api-bar/chem-constructor/README.md

# Химический конструктор «атомы + связи» — v2.0-beta5

> **EN:** Printable molecular model kit "atoms + bonds", version 2 (beta). New bayonet / lens / Reuleaux keys: single bonds rotate freely, rings close (cyclohexane), flexible single bonds, bond lengths engraved in Å, new elements (F, Cl, Na, K, Mg, Ca, S, P). Scale 90 mm/Å, real bond lengths and angles. **Not compatible with v1.0.** Print `04_tester/00_v2_prism_keys.3mf` first. License: [CC BY-NC-ND 4.0](LICENSE).

Детский/учебный конструктор молекул для 3D-печати (Bambu Lab A1). Масштаб 90 мм/Å, реальные валентные углы и длины связей, цвета CPK.
Вторая версия: новое крепление связь↔атом (одинарные связи **вращаются**, кольца замыкаются), гибкие связи, маркировка длин, новые элементы.
**Детали v2 несовместимы с v1.0.** Отличия — `docs/CHANGES_v1_to_v2.md`.

> **Статус: beta.** Релиз v2.0 — после выбора гибкой связи (spring или slots) по результатам печати и проверки защёлок в пластике. См. `STATUS.md`.

> **Что в репозитории.** Параметрический исходник OpenSCAD и скрипты сборки и проверки (`00_source/`), документация (`docs/`) и PNG-превью. STL, 3MF, GLB и USDZ
> на GitHub не публикуются: они входят в комплект v2, который распространяется отдельно — см. [docs/RELEASE.md](docs/RELEASE.md) и раздел «Лицензия».
> Набор v1.0 заморожен на теге `v1.0` и больше не развивается. По готовности v2 вливается в `main`.

## Структура

Структура полной папки набора; в git из неё только текст и PNG (`.gitignore` работает как белый список).

| Папка | Что внутри |
|---|---|
| `00_source/` | `chem_constructor.scad` (параметрический исходник v2, OpenSCAD), `chemlib.py`, `molecules.py`, `assemble3.py`, кэш посадок `seat_cache_v2.json`; `pipeline/` — скрипты проверки, пластин, превью, USDZ. Исходник v1.0 — на теге `v1.0` |
| `01_components/atoms/` | C Ø56, O Ø52, **N Ø52 с двойным пазом**, H Ø44, заглушка неподелённой пары |
| `01_components/bonds_rigid_labelled/` | жёсткие связи с гравировкой длины в Å: C–C, C–H, C–O, C–N, N–H, O–H, H–H; C=C, C=O, O=O, **N=O, C=N, N=N**; C≡C, C≡N, N≡N; универсальные без надписи: **U1** (C–C/C–O), **U2** (C–H/N–H/O–H), **UD1** (C=C/C=N), **UD2** (C=O/O=O/N=O/N=N), **UT** (C≡C/C≡N/N≡N) |
| `01_components/bonds_flex_spring/`, `bonds_flex_slots/` | 7 одинарных связей в двух гибких вариантах (решётка-стент / трубка с прорезями и внутренней спиралью) |
| `02_molecules/` | сборки `.glb` / `.usdz` / `.png`: вода, метан, этилен, CO₂, ацетилен, аммиак, этанол, L-аланин, циклогексан, **NO** |
| `03_plates/` | пластины: `01_v2_atoms…` (минимальный набор атомов), `02_v2_bonds_rigid_22…` (связи с маркировкой + универсальные), `05–07` гибкие связи (тест стоя/лёжа, все одинарные по вариантам; устаревшая пластина 08 с гибридным NO удалена — NO собирается связью N=O), циклогексан и вода по цветам |
| `04_tester/` | призма + ключи v2, по одному атому и связи каждого типа, тест гибкости (шейка) |
| `05_flex_bonds/` | разрезы и USDZ spring/slots, старые тестовые пластины 03/04 четырёх кандидатов, `old_candidates_neck_bellows/` |
| `06_v2_test_plates/` | атомы C, O, H и связи к ним на отдельных пластинах |
| `07_v2_new_elements/` | F, Cl, Na, K, Mg, Ca, S, P, N: STL, пластины, README со списком недостающих связей |
| `docs/` | **`KIT_v2_CATALOG.md`** (подробное описание набора, все компоненты, каталог молекул), `CHANGES_v1_to_v2.md`, `FLEX_BONDS.md` (устройство spring/slots), `MIN_SET_8_MOLECULES.md` (минимальный набор для C₂H₂, C₂H₄, C₂H₅OH, CH₄, CO₂, HCN, NO, NH₃), `README_beta4.md` (описание крепления и булевых проверок), `GIT_WORKFLOW.md` |

## Крепление (кратко)
- **Одинарная:** цилиндр Ø15 с 3 бугорками → круглый паз с входными бороздками, губой (натяг 0,3 мм) и кольцевой канавкой на глубине 4,5 мм. Вставить, совместив бугорки с бороздками, нажать до щелчка; дальше связь вращается свободно.
- **Двойная:** винтовой ключ-линза 28×7, правый винт, 2 положения. **Тройная:** винтовой ключ-треугольник Рёло 15, 3 положения. Клин у кончика, защёлка на сжатии пластика.
- Чужой ключ в паз не входит. Пазы углерода (8 шт.) и гибридизации — как в v1 (см. `docs/README_beta4.md`).
- **Азот:** 3 одинарных (пирамида), паз заглушки, тройной напротив заглушки, **двойной** (sp²: 120° к T0; HO–N=O собирается плоским).

## Печать
- **Атомы** — PLA, плоскостью с гравировкой вниз, слой 0,2, 3 стенки, 15 %. Поддержки: Enable support + tree(auto) + **Support critical regions only** (островок ≤11 мм² в устье нижнего паза у углерода и азота).
- **Связи** — PETG (гибкие — обязательно PETG), **стоя**, без поддержек, brim 5–8 мм, 4 стенки, 100 %. Гибкие можно печатать лёжа с поддержками (слои вдоль оси, прочнее на изгиб) — пластина 06.
- Сначала `04_tester/00_v2_prism_keys.3mf` → проверить щелчок и вращение; зазоры — `peg_clr`, `peg_lip`, `peg_bump`, `snap_clr`, `tip_clr` в SCAD.

## Сборка молекулы
Одинарную связь вставить до щелчка (бугорки — в бороздки), двойную/тройную ввинтить по часовой стрелке до щелчка. Длина на стержне (Å) подсказывает, какая связь куда. Сверяться с `.usdz` на телефоне или `.glb` в Blender.

## Лицензия
Содержимое репозитория — параметрический исходник OpenSCAD, скрипты, документация и изображения — распространяется по лицензии [CC BY-NC-ND 4.0](LICENSE):
печатать для себя и бесплатно для своего класса или кружка можно; продавать отпечатки и файлы, выкладывать переделки и производные — нельзя.
Указание автора и ссылка на репозиторий обязательны. Коммерческое использование (продажа отпечатков, наборов) — по отдельной коммерческой лицензии автора.
Исходник `chem_constructor.scad` можно менять для себя; распространять изменённые версии и полученные из них детали нельзя.
Файлы комплекта v2 (STL, 3MF, GLB, USDZ) на GitHub не публикуются; покупатель получает их на условиях личной лицензии v2 на той же основе CC BY-NC-ND 4.0.
Скрипты конвейера (`00_source/*.py`, `pipeline/`) те же, что в v1.0: на теге `v1.0` они доступны на условиях лицензии v1.

Набор содержит мелкие детали и не сертифицирован как детская игрушка: сборка — взрослым или под присмотром взрослого.
