api-bar/chem-constructor/STATUS.md

# Статус v2.0-beta5 (2026-10-18)

## Блокер релиза
Не выбрана конструкция гибкой связи. Кандидаты — **spring** и **slots** (`docs/FLEX_BONDS.md`); решение по печати пластин `03_plates/05_…STANDING` и `06_…LYING_supports`: где трещина при изгибе до 40°, где остаточная деформация. После выбора: `FLEX = "spring"|"slots"` в SCAD — и пересобрать одинарные связи.

## Сделано в beta5 (после beta4)
- spring переработан: 5 лент + 5 встречных тонких лент (решётка-стент) на сердечнике Ø3; slots: внутренняя 3-заходная спираль на сердечнике Ø4, скруглённые концы прорезей.
- Маркировка длины связи в Å на всех жёстких стержнях. Универсальные связи U1 (79 мм) и U2 (43 мм).
- Азот получил двойной паз (N_D, фаза 66° → плоский HO–N=O), связь N=O 1,15 Å; гибридный NO удалён. Сборка NO проверена (посадка 0,71 мм³, N∩O = 0).
- Пластины минимального набора для 8 молекул (атомы 12 шт., связи 19 шт.).
- **2026-10-23: этилен плоский.** `C_D_PHASE` −55,5 → −61,5: H–C=C–H = 0°/180° вместо 12°/168° (`docs/SP2_PLANARITY.md`, проверка — `00_source/pipeline/check_planar.py`). Углероды для C=C надо напечатать заново.
- Конвейер скриптов восстановлен в `00_source/pipeline/` (пути под рабочую папку v1 — адаптировать).

## Осталось до релиза
1. Печать и выбор гибкой связи; проверка натяга губы (`peg_lip`), удержания (`peg_bump`), исключения Рёло 15 ↔ круглый паз Ø15,6 (при слабой блокировке — Рёло 17).
2. Новый азот напечатать и проверить посадку N=O и заглушки в пластике.
3. Одинарные связи для новых элементов (20 пар) и первые молекулы с ними.
4. Пересобрать 20 молекул v1.0 на деталях v2, README по молекулам, пластины по цветам, BOM; адаптировать `pipeline/` под v2.
5. Маркировка длины на гибких стержнях (сейчас — только на жёстких).
6. LICENSE — CC BY-NC-ND 4.0 (по бизнес-плану); условия продажи и коммерческая лицензия — до первой продажи.

## Известные ограничения
- C=N и N=N при текущих фазах не плоские (57° и 66°), аллен: плоскости CH₂ под 61° вместо 90° — решение и расчёт в `docs/SP2_PLANARITY.md`, не применено (меняет напечатанные N и O).
- Азот с одинарными связями пирамидальный; плоский амидный N не реализован. Нет N=N.
- Пазы углерода не подписаны.
- Двойные и тройные связи жёсткие (гибкими сделаны только одинарные).
