api-bar/chem-constructor/docs/FLEX_BONDS.md

# v2.0-beta5 — гибкие связи: два финальных варианта (spring, slots) + связь NO

Решение: из четырёх кандидатов оставлены **spring** и **slots**, оба переработаны. Гибкий участок — 70 % длины стержня,
45°-пробки на концах, печать **стоя** без поддержек (все детали герметичны, одно тело, 0 островов).
Гибкими сделаны только **одинарные** связи; двойные и тройные — жёсткие (одинаковы в обоих вариантах).

| Вариант | Устройство | Почему прочнее |
|---|---|---|
| **spring** | тонкий сердечник Ø3 + **5 лент 2×2** по правой спирали 45° + **5 тонких лент 1,4×1,4 по левой спирали** на том же радиусе; ленты сплавлены в перекрестьях — решётчатая трубка Ø12 (как стент) | излом требует разрыва нескольких лент сразу; нагрузка расходится по всей решётке; сердечник держит длину |
| **slots** | трубка Ø12, стенка 1,5, кольцевые прорези 150° в шахматном порядке (концы прорезей скруглены) + **внутри** 3-заходная спираль 1,6×1,6 вокруг сердечника Ø4, соединённая с трубкой только через торцевые пробки | внутренняя спираль задаёт плавную кривизну (нет излома в одной прорези) и держит растяжение; при трещине перемычки связь не распадается |

Параметры в `chem_constructor.scad`: `FLEX = "spring" | "slots"`, `sp_*` (spring), `sl_*` и `flex_wall`, `flex_pitch` (slots).

## Файлы
| | |
|---|---|
| `stl/bond_<X>_spring.stl`, `stl/bond_<X>_slots.stl` | 7 одинарных (C–C, C–H, C–O, C–N, N–H, O–H, H–H) в двух вариантах |
| `stl/bond_CdC, CdO, OO, CtC, CtN, NN.stl` | жёсткие двойные/тройные |
| `stl/bond_NO.stl` | **новая** связь для NO (см. ниже) |
| `05_flex2_test_spring_slots_STANDING.3mf` | тест: C–C, C–H, O–H × оба варианта, стоя, PETG, без поддержек, brim 8 мм |
| `06_flex2_test_spring_slots_LYING_supports.3mf` | то же лёжа, с поддержками (tree, On build plate only, Top Z 0,25 или интерфейс PLA) |
| `07_singles_7x_spring_STANDING.3mf`, `07_singles_7x_slots_STANDING.3mf` | все одинарные одного варианта |
| `08_double_triple_NO_rigid_STANDING.3mf` | жёсткие двойные/тройные + NO |
| `usdz/` | C–C обоих вариантов, разрезы, рядом — для iPhone |
| `flex2_CC_sections.png` | гибкие участки и разрезы |

Старые стержни с шейкой (уже напечатанные) совместимы по ключам — меняется только средняя часть.

## Связь NO
У азота нет двойного паза (3 одинарных, паз заглушки, тройной), поэтому N=O обычным ключом не собрать.
Порядок связи в NO — 2,5, и связь сделана «гибридной»: **у азота ключ-Рёло (в тройной паз), у кислорода линза (в двойной паз)**, длина 1,15 Å.
Новый атом печатать не нужно.

## Минимальный набор для сборки по очереди: C₂H₂, C₂H₄, C₂H₅OH, CH₄, CO₂, HCN, NO, NH₃
Нужно по максимуму из всех молекул:

| Деталь | Шт. | Нужна для |
|---|---|---|
| C углерод | 2 | C₂H₂, C₂H₄, C₂H₅OH |
| H водород | 6 | C₂H₅OH |
| O кислород | 2 | CO₂ |
| N азот | 1 | HCN, NO, NH₃ |
| заглушка неподелённой пары | 1 | NH₃, HCN, NO (по желанию) |
| C–H | 5 | C₂H₅OH |
| N–H | 3 | NH₃ |
| C–C | 1 | C₂H₅OH |
| C–O | 1 | C₂H₅OH |
| O–H | 1 | C₂H₅OH |
| C=C | 1 | C₂H₄ |
| C=O | 2 | CO₂ |
| C≡C | 1 | C₂H₂ |
| C≡N | 1 | HCN |
| NO (гибрид) | 1 | NO |

Итого 11 атомов, 1 заглушка, 17 связей. Состав по молекулам:
C₂H₂: 2C, 2H, C≡C, 2 C–H · C₂H₄: 2C, 4H, C=C, 4 C–H · C₂H₅OH: 2C, O, 6H, C–C, 5 C–H, C–O, O–H · CH₄: C, 4H, 4 C–H ·
CO₂: C, 2O, 2 C=O · HCN: C, N, H, C≡N, C–H · NO: N, O, NO · NH₃: N, 3H, 3 N–H.
