api-bar/chem-constructor/docs/RELEASE.md

# Публикация v2.0-beta5: что где лежит

В git — исходники второй версии (OpenSCAD и скрипты) и документация. Печатные и 3D-файлы на GitHub **не публикуются**: ни в git, ни в GitHub Release.
Они входят в комплект v2, который распространяется отдельно (площадка продажи по бизнес-плану), и лежат только в локальной рабочей папке автора.
Набор v1.0 заморожен на теге `v1.0`. По готовности v2 вливается в `main`; отдельной долгоживущей ветки у второй версии нет.

## Что в git

| Что | Где |
|---|---|
| Параметрический исходник `chem_constructor.scad` (OpenSCAD); скрипты сборки и проверки: `chemlib.py`, `molecules.py`, `assemble3.py`, `seat_cache_v2.json`, `pipeline/` | `00_source/` |
| Документация: README набора, `STATUS.md`, каталог молекул и описание механизма | корень, `docs/`, `06_v2_test_plates/README.md`, `07_v2_new_elements/README.md` |
| PNG-превью: 10 сборок молекул, разрезы гибких связей, раскладка новых элементов | `02_molecules/*/`, `05_flex_bonds/`, `07_v2_new_elements/` |
| `LICENSE`, `.gitignore`, `make_kit_archives.sh` | корень |

`.gitignore` — белый список: `*.md`, `*.py`, `*.scad`, `*.json`, `*.sh`, `LICENSE` и PNG из перечисленных папок. Всё остальное, что лежит в рабочей папке, в коммиты не попадает.

## Что не публикуется на GitHub

| Что | Файлов | Размер | Где у автора |
|---|---|---|---|
| `01_components/` — STL атомов C, O, N, H, заглушки; 16 жёстких связей с гравировкой длины, 5 универсальных, по 7 одинарных spring и slots | 40 | ≈170 МБ | рабочая папка автора |
| `03_plates/` — пластины минимального набора (01 атомы, 02 связи), тесты гибких связей 05–07, циклогексан и вода по цветам | 12 | ≈34 МБ | то же |
| `04_tester/`, `06_v2_test_plates/` — призма + ключи, по одному атому и связи каждого типа, тест гибкости, атомы C/O/H и связи к ним | 15 | ≈53 МБ | то же |
| `02_molecules/*/` — `.glb` и `.usdz` 10 молекул | 20 | ≈72 МБ | то же |
| `05_flex_bonds/` — USDZ и разрезы spring/slots, пластины и STL ранних кандидатов | 10 | ≈19 МБ | то же |
| `07_v2_new_elements/` — STL F, Cl, Na, K, Mg, Ca, S, P, N, связи P=O и S=O, три пластины | 14 | ≈60 МБ | то же |

Не вошло в комплект как устаревшее: пластина `03_plates/08_double_triple_NO_rigid_STANDING.3mf` с гибридным ключом NO (заменён связью N=O)
и пластина `02_v2_bonds_rigid_19_…` (заменена `02_v2_bonds_rigid_22_…`).

## Архивы комплекта
`sh make_kit_archives.sh` из корня репозитория собирает шесть zip в `dist/` (около 116 МБ, в git не попадают). Пути внутри архивов совпадают
со структурой набора: распаковка всех шести в одну папку даёт полную папку. Это заготовка для загрузки на площадку продажи; состав стартового и полного комплекта (по бизнес-плану) собирается из них отдельно.

Что печатать первым покупателю: `04_tester/00_v2_prism_keys.3mf` — проверка щелчка, вращения и взаимного исключения ключей.

## Тег
Тег с датой на коммите набора — подтверждение приоритета авторства (`docs/ops/release-tags.md` в репозитории планирования). Готовая версия метится на `main`. GitHub Release с файлами не создаётся.

```
git tag -a v2.0-beta5 -m "v2.0-beta5 $(date +%Y-%m-%d)"
git push origin v2.0-beta5
```

## Лицензия
Содержимое репозитория — по [LICENSE](../LICENSE) в его корне. Файлы комплекта (STL, 3MF, GLB, USDZ) покупатель получает на условиях личной лицензии v2; коммерческое использование — по отдельной коммерческой лицензии.
