api-bar/chem-constructor/07_v2_new_elements/README.md

# v2: новые элементы для простых реакций (N, F, Na, Cl, K, Mg, Ca, S, P)

## Пластины
| Файл | Состав | Размер | Оценка печати* |
|---|---|---|---|
| `v2_new_elements_ALL_9.3mf` | все 9 атомов (зазор 6 мм) | 236×216×75 | ~490 г, ~23 ч |
| `v2_metals_Na_K_Mg_Ca.3mf` | Na, K, Mg, Ca | 162×154×75 | ~315 г, ~15 ч |
| `v2_nonmetals_N_F_Cl_S_P.3mf` | N, F, Cl, S, P | 196×120×57 | ~173 г, ~8 ч |
`layout.png` — раскладка. Атомы лежат плоскостью с гравировкой вниз, поддержки не нужны (все 8 новых атомов: 0 островков).
*Оценка по слайсу 8 углеродов (232 г, 11 ч при 15 % заполнении), масштабированная по объёму деталей; реальные значения даст ваш слайсер.

## Атомы
| Элемент | Z | Ø мм | Пазы | Подпись (валентность) | Цвет на пластине |
|---|---|---|---|---|---|
| N азот | 7 | 52 | 3 одинарных, заглушка, тройной | III | синий |
| F фтор | 9 | 44 | 1 одинарный | I | светло-зелёный |
| Cl хлор | 17 | 60 | 1 одинарный | I | зелёный |
| Na натрий | 11 | 68 | 1 одинарный | I | фиолетовый |
| K калий | 19 | 80 | 1 одинарный | I | тёмно-фиолетовый |
| Mg магний | 12 | 64 | 2 одинарных на 180° (оси под 45° к горизонту) | II | тёмно-зелёный |
| Ca кальций | 20 | 76 | 2 одинарных на 180° | II | бежевый |
| S сера | 16 | 62 | 2 одинарных + 2 двойных (тетраэдр) | II,IV,VI | жёлтый |
| P фосфор | 15 | 62 | 3 одинарных + 1 двойной | III,V | оранжевый |
Один паз Mg/Ca наклонён вверх, второй вниз: горизонтальные отверстия Ø15,6 печатались бы с провисающим потолком.

## Что собирается
Реакция → нужные связи (✔ уже есть, ⧗ нужно сгенерировать; STL с радиусами атомов на концах):
- 2Na + Cl₂ → 2NaCl: Cl–Cl ⧗, Na–Cl ⧗
- HCl + NaOH → NaCl + H₂O: H–Cl ⧗, Na–O ⧗, O–H ✔
- H₂ + F₂ → 2HF: H–H ✔, F–F ⧗, H–F ⧗
- N₂ + 3H₂ → 2NH₃: N≡N ✔, H–H ✔, N–H ✔
- Mg + 2HCl → MgCl₂ + H₂: Mg–Cl ⧗
- Ca(OH)₂: Ca–O ⧗, O–H ✔
- H₂S: S–H ⧗; H₂SO₄: S–O ⧗, S=O ✔ (`stl/bond_SdO.stl`), O–H ✔; SO₂: 2×S=O ✔
- H₃PO₄: P–O ⧗, P=O ✔ (`stl/bond_PdO.stl`), O–H ✔; PH₃: P–H ⧗
- CH₃Cl: C–Cl ⧗; NF₃: N–F ⧗

## Связи, которые нужно добавить (одинарные)
Печатная длина = длина − r₁ − r₂ + 32,6 мм; ключ — цилиндр, но радиус атома на конце зашит в связь, поэтому каждая пара — отдельный STL.
| Связь | Å | L, мм | Печатная длина, мм |
|---|---|---|---|
| H–F | 0.92 | 83 | 71 |
| H–Cl | 1.27 | 114 | 95 |
| F–F | 1.42 | 128 | 116 |
| Cl–Cl | 1.99 | 179 | 152 |
| N–F | 1.36 | 122 | 107 |
| C–F | 1.35 | 122 | 104 |
| C–Cl | 1.77 | 159 | 134 |
| S–H | 1.34 | 121 | 100 |
| P–H | 1.42 | 128 | 107 |
| S–O | 1.57 | 141 | 117 |
| P–O | 1.60 | 144 | 120 |
| Na–Cl | 2.36 | 212 | 181 |
| Na–O | 1.95 | 176 | 148 |
| Na–H | 1.89 | 170 | 147 |
| K–Cl | 2.67 | 240 | 203 |
| K–O | 2.20 | 198 | 165 |
| Mg–Cl | 2.18 | 196 | 167 |
| Mg–O | 1.77 | 159 | 134 |
| Ca–Cl | 2.50 | 225 | 190 |
| Ca–O | 2.00 | 180 | 149 |
Самые длинные: K–Cl (~203 мм) и Na–Cl (~181 мм) — стоя помещаются в Z=256 мм A1.

## Проверено по STL
- 8 новых атомов: герметичны, по одному телу, 0 послойных островков.
- Одинарные пазы F, Cl, Na, K, Mg (2), Ca (2), S (2), P (3): ключ садится, остаток 0,00 мм³, вращение свободно.
- Двойные пазы: P=O (158°) 0,47 мм³; S=O в оба двойных паза S 0,47 и 0,68 мм³; кислородный конец обеих связей 0,60 мм³ — как у линзы кислорода в v2.
- Из этого набора ещё не собрана ни одна молекула целиком: нужны недостающие связи ⧗.

## Ограничения
1. **Металлы — ионные соединения.** Na–Cl, Ca–O в кристалле не имеют направленных связей; набор показывает формульную единицу «шарик–палочка» и длины пар в газовой фазе. Решётку поваренной соли из него не собрать.
2. **Углы S и P идеализированы** тетраэдром 109,5°: у H₂S реально 92°, у PH₃ 93,5°, у SO₂ 119°.
3. **Размеры не по шкале для лёгких элементов:** F ограничен снизу размером паза (Ø44), как водород.
4. **Не включены:** Br, I (копии Cl с другим радиусом), Al (3 одинарных на 120°), Fe, Cu, Zn (переменная валентность). Br, I, Al добавляются за час.
5. K (Ø80, 262 см³) — самая тяжёлая деталь набора.
