api-bar/chem-constructor/docs/KIT_v2_CATALOG.md

# Конструктор «атомы + связи» v2 — описание набора, компоненты и каталог молекул

Состояние: v2.0-beta5, 2026-10-18. Масштаб **90 мм на 1 Å**: расстояние между центрами атомов = реальная длина связи × 90.
Углы между пазами — реальные валентные. Цвета атомов — CPK. Все детали печатаются на Bambu Lab A1 (стол 256×256 мм).

---

## 1. Как устроен набор

Набор состоит из **атомов** (шары с пазами) и **связей** (стержни с ключами на концах). Тип паза и ключа кодирует **кратность связи**:
чужой ключ в паз не входит, поэтому собрать «неправильную» молекулу нельзя.

| Кратность | Ключ на связи | Паз в атоме | Как соединять |
|---|---|---|---|
| **Одинарная** | цилиндр Ø15, длина 16,3 мм, у основания 3 полусферических бугорка 0,8 мм через 120° | круглое отверстие Ø15,6; от устья идут 3 входные бороздки; перед кольцевой канавкой (глубина 4,5 мм) их дно поднято — **губа** с натягом 0,3 мм | совместить бугорки с бороздками, нажать до щелчка. Дальше связь **свободно вращается** вокруг своей оси. Вынуть — снова совместить с бороздками и потянуть |
| **Двойная** | витой ключ, сечение **линза** 28×7 мм, правый винт, конус к основанию, бугорок 0,9 мм | винтовая щель-линза с винтовым входным каналом и губой | ввинтить по часовой стрелке (если смотреть на атом) ~⅓ оборота до щелчка. 2 положения (через 180°), угол поворота фиксирован — как у настоящей двойной связи |
| **Тройная** | витой ключ, сечение **треугольник Рёло** 15 мм, 1 бугорок | винтовая щель-Рёло, 3 входных канала с губой | ввинтить до щелчка, 3 положения (через 120°) |

Фиксация везде одинаковая по принципу: **клин** (конус ключа зажимается в конической щели) + **защёлка** на сжатии пластика (бугорок проходит губу и падает в канавку/лунку). Пружинящих элементов нет.

Длина каждой связи — реальная для своей пары атомов (например, C–C 1,54 Å → 139 мм между центрами), и на стержне она **выгравирована в ангстремах**.

---

## 2. Атомы

Радиусы подобраны так, чтобы все пазы поместились без пересечений; шар срезан плоскостью снизу (для печати), на срезе гравировка: символ, валентность, заряд ядра, атомная масса.

| Атом | Цвет | Ø, мм | Пазы | Какие геометрии даёт |
|---|---|---|---|---|
| **H** водород | белый | 44 | 1 одинарный | концевой атом |
| **C** углерод | чёрный | 56 | **8 пазов**: 4 одинарных (тетраэдр T0–T3), 2 двойных (Д1, Д2 — напротив друг друга), 1 тройной (напротив T1) | **sp³** — T0,T1,T2,T3 (метан, алканы) · **sp²** — T0,T1 + Д1, плоский (этилен, карбонил, карбоксил, амид) · **sp (=,=)** — Д1 + Д2 (CO₂, аллен) · **sp (−,≡)** — T1 + тройной (ацетилен, нитрилы) |
| **O** кислород | красный | 52 | 2 одинарных под 104,5°, 1 двойной; неподелённые пары — бугорки | вода, спирты, эфиры (2 одинарных); карбонил, O₂ (двойной) |
| **N** азот | синий | 52 | 3 одинарных (пирамида, 107°), паз заглушки неподелённой пары, 1 тройной (напротив заглушки), **1 двойной** (sp²: 120° к T0, в плоскости T0–T1) | аммиак, амины, амиды (3 одинарных + заглушка); N₂, нитрилы (тройной); N=O, имины, азо (двойной + T0, заглушка в T1) |
| **заглушка неподелённой пары** | розовый/белый | — | круглый ключ одинарного типа | закрывает пустой одинарный паз азота (или любой другой) — показывает неподелённую пару |

Как различить пазы углерода: тройной — самый толстый; T1 — строго напротив тройного; Д1 — двойной рядом с парой одинарных T2, T3; Д2 — напротив Д1, рядом с ним T0. Выбор между T2 и T3 задаёт L/D-форму аминокислот.

### Новые элементы (`07_v2_new_elements/`, атомы готовы, свои связи — частично)

| Атом | Цвет | Ø, мм | Пазы | Примечание |
|---|---|---|---|---|
| **F** фтор | светло-зелёный | 44 | 1 одинарный | |
| **Cl** хлор | зелёный | 60 | 1 одинарный | |
| **Na** натрий | фиолетовый | 68 | 1 одинарный | ионные соединения показываются как «связь» |
| **K** калий | фиолетовый | 80 | 1 одинарный | |
| **Mg** магний | тёмно-зелёный | 64 | 2 одинарных под 180° (оси наклонены на 45° к плоскости печати) | |
| **Ca** кальций | тёмно-зелёный | 76 | 2 одинарных под 180° | |
| **S** сера | жёлтый | 62 | 2 двойных + 2 одинарных (тетраэдр) | SO₂, S=O; H₂S — нужна связь S–H |
| **P** фосфор | оранжевый | 62 | 1 двойной + 3 одинарных (тетраэдр) | P=O; фосфаты — через U1 |

---

## 3. Связи

Стержень Ø12 мм, ключи на концах по типу пазов. Цвет (рекомендация): **оранжевые** — полярные (C–O, O–H, N–H, C–N, C=O, C≡N, N=O, S=O, P=O), **серые** — неполярные (C–C, C–H, H–H, C=C, C≡C, N≡N, O=O), **зелёные** — универсальные.

### 3.1 Одинарные (`bonds_rigid_labelled/`, с гравировкой длины)

| Связь | Å | Между центрами, мм | Видимый стержень, мм | Для чего |
|---|---|---|---|---|
| C–C | 1,54 | 139 | 83 | алканы, боковые цепи |
| C–O | 1,43 | 129 | 75 | спирты, эфиры, кислоты |
| C–N | 1,47 | 132 | 78 | амины, амиды, аминокислоты |
| C–H | 1,09 | 98 | 48 | |
| N–H | 1,01 | 91 | 43 | |
| O–H | 0,96 | 86 | 38 | |
| H–H | 0,74 | 67 | 23 | только H₂ |

Каждая одинарная есть в трёх исполнениях: **жёсткая** (гравировка длины), **гибкая spring**, **гибкая slots** — ключи одинаковые, отличается только середина стержня (см. раздел 4).

### 3.2 Универсальные одинарные (без гравировки)

| | Стержень | Между центрами с атомами | Заменяет | Погрешность |
|---|---|---|---|---|
| **U1** | 79 мм | C–C 135 (1,50 Å), C–O 133 (1,48), **N–O 131 (1,46)**, **N–N 131 (1,46)**, **O–O 131 (1,46)**, P–O 136 (1,51), C–F 129 (1,43) | C–C, C–O, а также одинарные **N–O, N–N, O–O, P–O**, которых нет отдельными деталями | 3–6 % |
| **U2** | 43 мм | C–H 93 (1,03 Å), N–H 91 (1,01), O–H 91 (1,01), **H–F 87 (0,96)** | C–H, N–H, O–H, **H–F** | до 6 % |

U1 важна не только как «упрощение»: с ней собираются пероксид водорода, гидразин, азотистая кислота, нитросоединения, фосфорная кислота — молекулы с одинарными связями N–O, N–N, O–O, P–O.

### 3.3 Двойные (специальные, с гравировкой длины)

| Связь | Å | Применение |
|---|---|---|
| C=C | 1,34 | алкены, бутадиен, бензол (Кекуле) |
| C=O | 1,21 | альдегиды, кетоны, кислоты, CO₂, амиды |
| O=O | 1,21 | O₂, озон (с U1) |
| **N=O** | 1,15 | NO, нитрозо-, HNO₂, NO₂, нитро-группа |
| **C=N** | 1,28 | имины, оксимы, гуанидин (аргинин) |
| **N=N** | 1,25 | азосоединения, диазен |
| S=O | 1,43 | SO₂ |
| P=O | 1,48 | фосфорная кислота, фосфаты |

### 3.4 Тройные (специальные, с гравировкой длины)

| Связь | Å | Применение |
|---|---|---|
| C≡C | 1,20 | ацетилен, алкины |
| C≡N | 1,16 | HCN, нитрилы |
| N≡N | 1,10 | N₂ |

### 3.5 Универсальные двойные и тройная (без гравировки)

Ключи те же (линза / Рёло), отличается только длина стержня — среднее по группе. Посадка проверена булевой сборкой: UD2 в O 0,48 мм³, в C 0,79, в N 0,43; UT в C 0,04, в N 1,43 (как у специальных).

| | Стержень | Заменяет | Погрешность |
|---|---|---|---|
| **UD1** | 63 мм | C=C (1,32 вместо 1,34 Å), C=N (1,30 вместо 1,28) | ≤2 % |
| **UD2** | 55 мм | C=O (1,21), O=O (1,19 вместо 1,21), N=O (1,19 вместо 1,15), N=N (1,19 вместо 1,25) | ≤5 % |
| **UT** | 50 мм | C≡C (1,18 вместо 1,20), C≡N (1,16), N≡N (1,13 вместо 1,10) | ≤3 % |

Итого универсальных связей пять: U1, U2 (одинарные), UD1, UD2 (двойные), UT (тройная). Из них одних можно собрать любую молекулу каталога с погрешностью длин до 6 %, а специальные связи с гравировкой показывают точные длины.

### 3.5a Чего нет (и что это закрывает)

| Нет связи | Длина, Å | Не собрать | Как добавить |
|---|---|---|---|
| C≡O | 1,13 | угарный газ CO | у кислорода нет тройного паза — нужен новый кислород |
| S–H, C–S | 1,34 / 1,81 | H₂S, тиолы, метионин, цистеин | две одинарные связи (круглые ключи) |
| H–Cl, C–Cl, Cl–Cl | 1,27 / 1,77 / 1,99 | HCl, хлорметаны, Cl₂ | одинарные связи |
| Na–Cl, K–Cl, Mg–Cl, Ca–O… | 2,0–2,8 | соли | длинные одинарные связи (20 пар — таблица в `07_v2_new_elements/README.md`) |
| S=O ×3 на одном S | — | SO₃, H₂SO₄ | у серы 2 двойных паза |

---

## 4. Гибкие связи (одинарные)

Гибкий участок — 70 % длины стержня, снаружи Ø12, на концах 45°-пробки (печать стоя без мостов). Два финальных варианта, выбор — по печати:

| Вариант | Устройство | Идея прочности |
|---|---|---|
| **spring** | сердечник Ø3 + 5 лент 2×2 по правой спирали 45° + 5 тонких лент 1,4×1,4 по левой спирали на том же радиусе, сплавлены в перекрестьях (решётка-стент) | излом требует разрыва нескольких лент; нагрузка распределена по решётке; сердечник держит длину |
| **slots** | трубка стенка 1,5 с кольцевыми прорезями 150° в шахматном порядке (скруглённые концы) + внутри 3-заходная спираль 1,6×1,6 на сердечнике Ø4, соединённая с трубкой только через торцы | внутренняя спираль задаёт плавную кривизну и держит растяжение; при трещине перемычки связь не распадается |

Двойные и тройные связи — жёсткие (поворот вокруг них и так зафиксирован ключом).

---

## 5. Тестеры и вспомогательное

| Деталь / пластина | Назначение |
|---|---|
| `04_tester/00_v2_prism_keys.3mf` | призма с пазами всех трёх типов + ключи: проверка посадки, щелчка, вращения, взаимного исключения |
| `04_tester/01_v2_HNCO_single_double_triple.3mf` | по одному атому H, N, C, O и связи каждого типа |
| `03_plates/05_…STANDING`, `06_…LYING_supports` | тест гибкости: C–C, C–H, O–H × spring/slots, стоя и лёжа |
| `06_v2_test_plates/` | атомы C, O, H и связи к ним |

---

## 6. Каталог молекул

Обозначения статуса:
- **✅** собрана из печатных STL и проверена булевой сборкой (пересечений нет);
- **✔** собирается из деталей набора точно (нужные пазы, углы и связи есть), сборкой пока не проверялась;
- **≈** собирается, но с универсальной связью или с приближённым углом — указано, что именно;
- **⟳** кольцо: геометрически замыкается, нужна проверка сборкой (ошибка замыкания);
- **✖** не собрать — указано, чего не хватает.

Состав: атомы / связи. Заглушка (з) ставится в свободный паз азота.

### 6.1 Простые вещества и неорганика

| Молекула | Состав | Статус / примечание |
|---|---|---|
| H₂ | 2H / H–H | ✔ |
| O₂ | 2O / O=O | ✔ |
| N₂ | 2N / N≡N (+2 з) | ✔ |
| F₂ | 2F / U1 | ≈ 1,46 вместо 1,42 Å |
| HF | H, F / U2 | ≈ 0,96 вместо 0,92 Å |
| Cl₂, HCl | | ✖ нет связей нужной длины |
| H₂O вода | O, 2H / 2 O–H | ✅ |
| H₂O₂ пероксид | 2O, 2H / 2 O–H, U1 | ≈ O–O через U1 (1,46 ≈ 1,48 Å); двугранный угол свободный — можно показать «книжку» |
| O₃ озон | 3O / O=O, U1 | ≈ угол 104,5° вместо 117° |
| NH₃ аммиак | N, 3H / 3 N–H (+з) | ✅ |
| N₂H₄ гидразин | 2N, 4H / 4 N–H, U1 (+2 з) | ≈ N–N через U1 (1,46 ≈ 1,45 Å) |
| NO | N, O / N=O | ✅ пустой T0 — неспаренный электрон |
| NO₂ | N, 2O / N=O, U1 | ≈ угол 120° вместо 134°, второй O через U1 |
| HNO₂ азотистая к-та | N, 2O, H / N=O, U1, O–H (+з) | ≈ **плоская** (фаза паза подобрана), N–O через U1 |
| HNO₃ азотная к-та | N, 3O, H / N=O, 2 U1, O–H | ≈ третий O в T1 (пирамидально, не плоско) |
| CO₂ | C, 2O / 2 C=O | ✅ линейная, Д1+Д2 |
| CO угарный газ | | ✖ нет C≡O (нет тройного паза у O) |
| HCN синильная к-та | C, N, H / C≡N, C–H (+з) | ✔ линейная |
| SO₂ | S, 2O / 2 S=O | ≈ угол 109,5° вместо 119° |
| H₂S, SO₃, H₂SO₄ | | ✖ нет S–H; у S только 2 двойных паза |
| H₃PO₄ фосфорная к-та | P, 4O, 3H / P=O, 3 U1, 3 O–H | ≈ P–O через U1 (1,51 ≈ 1,57 Å) |
| NaCl, KCl, MgCl₂, CaO… | | ✖ нет длинных связей (см. `07_v2_new_elements/README.md`) |

### 6.2 Углеводороды

| Молекула | Состав | Статус |
|---|---|---|
| CH₄ метан | C, 4H / 4 C–H | ✅ |
| C₂H₆ этан | 2C, 6H / C–C, 6 C–H | ✔ заслонённая/заторможенная конформации — вращение свободно |
| C₃H₈ пропан, C₄H₁₀ бутан, изобутан, пентаны… | nC, (2n+2)H / (n−1) C–C, (2n+2) C–H | ✔ любые алканы, разветвлённые — тоже |
| C₂H₄ этилен | 2C, 4H / C=C, 4 C–H | ✅ плоский (H–C=C–H = 0°/180°, `C_D_PHASE = -61.5`, проверено `check_planar.py`; в beta5 была закрутка 12°) |
| C₃H₆ пропен, бутены, изобутен | | ✔ sp² углерод: T0, T1 + Д1 |
| C₄H₆ бутадиен | 4C, 6H / 2 C=C, C–C, 6 C–H | ✔ s-транс/s-цис — поворот вокруг C–C |
| C₃H₄ аллен H₂C=C=CH₂ | 3C, 4H / 2 C=C, 4 C–H | ✔ центральный C: Д1+Д2; концевые CH₂ сейчас под 61° вместо 90°: нужна отдельная фаза паза −C_D (см. `SP2_PLANARITY.md`) |
| C₂H₂ ацетилен | 2C, 2H / C≡C, 2 C–H | ✅ линейный |
| C₃H₄ пропин, бутин | | ✔ |
| C₆H₁₂ циклогексан | 6C, 12H / 6 C–C, 12 C–H | ✅ кресло, замыкание 0,0 мм |
| метилциклогексан и др. замещённые | | ✔ (на основе циклогексана) |
| C₅H₁₀ циклопентан | 5C, 10H / 5 C–C | ⟳ углы 109,5° против ~104° в кольце — жёсткими стержнями не замкнуть точно; с гибкими — проверить |
| C₆H₆ бензол (Кекуле) | 6C, 6H / 3 C=C, 3 C–C, 6 C–H | ⟳ углы T1–Д1 = 120,5°, шестиугольник с чередующимися сторонами замыкается; проверить сборкой |
| толуол, ксилолы, стирол | | ⟳ после бензола |
| циклопропан, циклобутан | | ✖ углы 60°/90° недостижимы |

### 6.3 Кислородсодержащие

| Молекула | Состав | Статус |
|---|---|---|
| CH₃OH метанол | C, O, 4H / C–O, 3 C–H, O–H | ✔ |
| C₂H₅OH этанол | 2C, O, 6H / C–C, C–O, 5 C–H, O–H | ✅ |
| пропанолы, бутанолы, изопропанол | | ✔ |
| этиленгликоль, глицерин | | ✔ |
| CH₃OCH₃ диметиловый эфир, диэтиловый эфир | | ✔ угол C–O–C 104,5° (реально 111°) |
| H₂CO формальдегид | C, O, 2H / C=O, 2 C–H | ✔ плоский |
| CH₃CHO ацетальдегид, ацетон | | ✔ |
| HCOOH муравьиная к-та | C, 2O, 2H / C=O, C–O, C–H, O–H | ✔ |
| CH₃COOH уксусная к-та | 2C, 2O, 4H / C–C, C=O, C–O, 3 C–H, O–H | ✅ (v1), ✔ v2 |
| пропионовая, масляная к-ты | | ✔ |
| щавелевая к-та HOOC–COOH | 2C, 4O, 2H / C–C, 2 C=O, 2 C–O, 2 O–H | ✔ |
| молочная к-та, пировиноградная к-та | | ✔ |
| метилацетат, этилацетат (сложные эфиры) | | ✔ (метилацетат собран в v1) |
| глюкоза, фруктоза, рибоза — **открытая форма** | 6C, 6O, 12H | ✔ |
| глюкоза — пиранозное кольцо | | ⟳ 6-членное кольцо с O (угол у O 104,5°) — проверить |
| угольная к-та H₂CO₃ | C, 3O, 2H / C=O, 2 C–O, 2 O–H | ✔ |

### 6.4 Азотсодержащие

| Молекула | Состав | Статус |
|---|---|---|
| CH₃NH₂ метиламин, этиламин, диметиламин, триметиламин | | ✔ N пирамидальный (+з) |
| CH₃CN ацетонитрил | 2C, N, 3H / C–C, C≡N, 3 C–H | ✔ |
| HCONH₂ формамид, CH₃CONH₂ ацетамид | | ≈ амидный N пирамидальный (реально плоский) |
| мочевина (NH₂)₂C=O | C, O, 2N, 4H / C=O, 2 C–N, 4 N–H | ≈ то же |
| CH₃NO₂ нитрометан | C, N, 2O, 3H / C–N, N=O, U1, 3 C–H | ≈ нитрогруппа через N=O + U1 |
| CH₂=NH метанимин, имины R₂C=NR | | ≈ новая связь C=N; N: двойной + T0 + заглушка; **не плоский** (отклонение 57°), см. `SP2_PLANARITY.md` |
| оксимы R₂C=N–OH | | ≈ N–O через U1 |
| диазен HN=NH, азометан | | ≈ новая связь N=N; **не плоский** (отклонение 66°), см. `SP2_PLANARITY.md` |
| гуанидин, аргинин | | ✔ через C=N |
| пиридин, пиррол, имидазол | | ⟳ / ✖ пиридин — как бензол с N (проверить); 5-членные — не замкнуть |

### 6.5 Аминокислоты и пептиды

Все L-аминокислоты собираются в S-конфигурации (правило в README v1: H у Cα от себя, N → COOH → боковая цепь против часовой стрелки).

| Аминокислота | Статус |
|---|---|
| Gly, Ala, Val, Leu, Ile, Ser, Thr, Asn, Gln, Asp, Glu, Lys | ✔ (Ala собрана в v2; Gly, Val, Ser, Asn, Thr, Leu, Asp, Lys — в v1, в v2 те же пазы) |
| Arg | ✔ через новую C=N |
| Phe, Tyr | ⟳ бензольное кольцо |
| Pro | ⟳ 5-членное кольцо — вероятно, не замкнётся жёсткими стержнями |
| Met, Cys | ✖ нет C–S, S–H |
| Trp, His | ✖ 5-членные гетероциклы |
| Gly-Gly, Ala-Gly, трипептиды | ✔ пептидная связь: C=O в Д1, C–N, N–H (+з) |

### 6.6 Что можно показать благодаря v2 (чего не могла v1)

- **Конформации**: поворот вокруг одинарных связей — заслонённый/заторможенный этан, гош/анти бутан, кресло циклогексана.
- **Кольца**: циклогексан (проверен), бензол и пиранозы (проверить).
- **Жёсткость кратных связей**: C=C не крутится (цис/транс-бутен-2 — две разные молекулы), C–C крутится.
- **Гибкость связи**: деформация и возврат (spring/slots).
- **Азот sp²**: NO, нитрозо-, азотистая кислота (плоская), имины, азосоединения.
- **Длины связей**: гравировка в Å позволяет сравнивать C–C 1,54 / C=C 1,34 / C≡C 1,20 прямо на деталях.

---

## 7. Рекомендуемый состав набора (чтобы собирать молекулы из разделов 6.1–6.5 по одной)

| Деталь | Шт. | Деталь | Шт. |
|---|---|---|---|
| C | 6 | C–H (жёсткая или гибкая) | 12 |
| H | 14 | C–C | 5 |
| O | 4 | C–O | 2 |
| N | 2 | C–N | 2 |
| заглушка | 2 | N–H | 4 |
| | | O–H | 3 |
| | | U1 / U2 | 3 / 2 |
| | | UD1 / UD2 / UT | 2 / 2 / 1 |
| | | C=C | 3 |
| | | C=O | 2 |
| | | C≡C, C≡N, N≡N, O=O, N=O, C=N, N=N | по 1 |

Этого хватает на циклогексан, бензол (для проверки), лизин, Gly-Gly, глюкозу в открытой форме и всё более простое.
Минимальный набор на 8 молекул (C₂H₂, C₂H₄, C₂H₅OH, CH₄, CO₂, HCN, NO, NH₃) — в `MIN_SET_8_MOLECULES.md`: 11 атомов, 1 заглушка, 17 связей.
