api-bar/chem-constructor/docs/MIN_SET_8_MOLECULES.md

# Пластины минимального набора v2 — связи с маркировкой длины, азот с двойным пазом

## Что изменилось
1. **Маркировка.** На каждом стержне с двух сторон выгравирована длина связи в ангстремах («0.96 Å», «1.54 Å»…), глубина 1 мм, шрифт DejaVu Sans Bold 4,5 мм.
   Одинарные связи разной длины теперь различаются по надписи. (У гибких spring/slots середина — решётка, там надписи пока нет.)
2. **Азот получил двойной паз** `N_D = [-0.866, 0, -0.5]`: 120° к одинарному T0, 130,5° к T1 (сюда — заглушка неподелённой пары), 54,9° к T2/T3, 125° к тройному.
   T0, T1 и N_D лежат в одной плоскости — sp²-азот (R–N=O, HO–N=O, имины). Фаза паза `N_D_PHASE = 66` подобрана так, что
   двугранный угол T0–N=O–(одинарный O) = 0,0°: HO–N=O собирается **плоским**, как настоящая азотистая кислота.
   Посадка линзы в паз азота: 0,71 мм³ (как у кислорода 0,59 мм³), N и O в сборе NO не пересекаются.
3. **Связь N=O** — обычная двойная (линза с обеих сторон), 1,15 Å, `bond_NdO`. Гибридная «Рёло + линза» удалена.
   NO собирается как N + N=O + O; одинарный паз T0 у азота остаётся пустым — это неспаренный электрон радикала NO.

## Пластины
| Пластина | Состав | Печать |
|---|---|---|
| `01_v2_atoms_2C_2O_1N_6H_cap.3mf` | C×2, O×2, **N (новый, с двойным пазом)**×1, H×6, заглушка×1 | PLA, плоскостью вниз, слой 0,2, 3 стенки, 15 %. Enable support + tree(auto) + «Support critical regions only»: у углерода и теперь у азота есть островок ≤11 мм² в устье паза, смотрящего вниз |
| `02_v2_bonds_rigid_19_labelled_plus_universal_STANDING.3mf` | C–H×5, N–H×3, C–C, C–O, O–H, C=C, C=O×2, C≡C, C≡N, **N=O** — все с гравировкой длины; плюс **универсальные U1 и U2** (зелёные, без маркировки) | PETG или PLA, стоя, без поддержек, brim 5 мм, 4 стенки, 100 %. Оранжевые — полярные, серые — неполярные |

`stl/` — все связи пластины (+ H–H) и `nitrogen_v2b.stl`. `NO_assembly/` — NO в сборе (`.glb`, `.usdz`, `.png`).
`chem_constructor.scad`, `chemlib.py` — обновлённые исходники (азот: паз 5 = N_D; связь ("N","O",2) → `bond_NdO`).

Уже напечатанный азот без двойного паза годится для HCN и NH₃; для NO нужен новый.

## Универсальные одинарные связи (без маркировки)
| | Стержень | Заменяет | Погрешность |
|---|---|---|---|
| **U1** `bond_U1` | 79 мм | C–C, C–O | C–C 1,50 Å вместо 1,54; C–O 1,48 вместо 1,43 (±3 %) |
| **U2** `bond_U2` | 43 мм | C–H, N–H, O–H | C–H 1,03 вместо 1,09; N–H 1,01; O–H 1,01 вместо 0,96 (±6 %) |

Ключи одинаковые с обеих сторон (цилиндр Ø15 с бугорками), подходят к любому одинарному пазу. Параметры `uni_rod_1`, `uni_rod_2` в SCAD.
