api-bar/chem-constructor/docs/README_beta4.md

# Химический конструктор v2.0-beta4 — новое крепление связь↔атом

> **БЛОКЕР РЕЛИЗА v2.0:** версия не релизится, пока не решён вопрос гибкой связи — какой тип гибкого стержня принимается
> (утонение / сильфон / прорези / пружина) и подтверждён печатью: гнётся, возвращается, не ломается, не провисает, держит ключи.
> Тестовая пластина: `05_flex_bonds/03_v2_flex_variants_test.3mf`.

## Крепления
| Связь | Ключ на связи | Паз в атоме | Поведение |
|---|---|---|---|
| одинарная | **цельный цилиндр Ø15, длина 16,3**; у основания 3 полусферических бугорка 0,8 мм (120°) | круглое отверстие Ø15,6; 3 **входные бороздки** от устья; перед кольцевой бороздой их дно поднято — **губа** (натяг 0,3 мм, проходится на сжатии пластика); **кольцевая борозда** на глубине 4,5 | вставить, совместив бугорки с бороздками, нажать до щелчка через губу; дальше **вращается свободно**; вынуть — только снова совместив бороздки и преодолев губу; мимо бороздок вытянуть нельзя (упор в стенку 0,5 мм) |
| двойная | винт, сечение **линза** 28×7, **конус** (шире к основанию), бугорок 0,9 на одной стороне | винтовая щель-линза; **винтовой входной канал** под бугорок от устья до лунки с губой (натяг 0,3 мм) | правый винт, 2 положения (180°); бугорок идёт по каналу без натяга, проходит губу на сжатии пластика, падает в лунку |
| тройная | винт, сечение **треугольник Рёло** 15, 1 бугорок | винтовая щель-Рёло; 3 винтовых канала с губой и 3 лунки | правый винт, 3 положения (120°); та же защёлка на сжатии |

Без пружинящих элементов — только сжатие пластика на губе. Взаимное исключение: цилиндр Ø15 не входит в линзу (7,9) и Рёло (вписанная 13,5); Рёло 15 не входит в круглое 15,6? — **входит с зазором 0,6 → см. «известные вопросы»**; линза не входит никуда, кроме своего.
Водород увеличен до Ø44 (стенка у устья круглого паза 1,5 мм). Стержни: шейка Ø7 на 70 % длины — гнутся и возвращаются (PETG).

## Клин (как в v1)
Щель коническая: у входа зазор 0,45, у дна 0,15; ключ конический (шире к основанию на 0,6). Измерено по STL: зазор лопасть↔щель
0,11–0,12 мм в губе и 0,15 у кончика (в beta2 у кончика было 0,24) — лопасть зажата по всей длине, и в губе, и у кончика.

## Примеры собранных молекул (02_molecules)
Каждая папка: `.glb` (Blender / любой 3D-просмотрщик — видно, как ключи сидят в пазах), `.usdz` (iPhone: тап → AR), `.png`.
Вода, метан, этилен, CO₂, ацетилен, аммиак, этанол, L-аланин, **циклогексан** (замкнутое кольцо, 36 деталей). Все собраны из печатных STL без столкновений.

## Проверено по STL (булевы проверки)
- одинарная в водороде: посажена — 0 мм³ при любом повороте (свободное вращение); ход по бороздкам — 0 до губы, 0,9 мм³ на губе (0,3 мм × 3 бугорка), затем 0; мимо бороздок — 2,4 мм³ (упор);
- линза в кислороде 0,6 мм³ (огранка); вывинчивание O=O по спирали: 0 мм³ везде, кроме губы (0,3 мм³); Рёло в азоте: по спирали ≤1,65 мм³ на губе, затем 0;
- **циклогексан замыкается точно (0,0 мм)**, 36 деталей, без столкновений — `02_molecules/cyclohexane.glb`; также вода, метан, этилен, CO₂, ацетилен, аммиак;
- 21 деталь герметична, одно тело; острова: углерод 2 (9,9 мм² — крыша винтового канала у устья паза, смотрящего вниз; 1,7), азот 3×0,5, призма 4×2,6 — потолки борозд/каналов в наклонных пазах; для углерода включить «Support critical regions only».

## Известные вопросы (проверить в пластике)
1. Рёло 15 vs круглый паз 15,6: по ширине Рёло входит в круглое отверстие — блокирует только то, что у Рёло нет бугорков под бороздки и его винт не «ведёт» в гладком отверстии; если это окажется слабым — увеличить Рёло до 17 (тогда вписанная 15,2 > цилиндра 15: цилиндр в Рёло не войдёт, Рёло в круглый — тоже).
2. Усилие на губе (`peg_lip` 0,9 → натяг 0,3) и удержание (`peg_bump` 0,8).
3. Гибкость шейки Ø7 (`rod_neck_d`), тестер 02.

## Содержимое
| Папка | Что внутри |
|---|---|
| `00_source/` | SCAD v2 (`chem_constructor.scad`), SCAD v1 для сравнения, `chemlib.py`, `molecules.py`, `assemble3.py`, кэш посадок v2 |
| `01_components/` | 18 деталей v2 (STL): атомы C, N, O, H, заглушка и 13 связей |
| `02_molecules/` | GLB / USDZ / PNG сборок: вода, метан, этилен, CO₂, ацетилен, аммиак, этанол, L-аланин, циклогексан |
| `03_plates_by_color/` | пластины по цветам: циклогексан и две молекулы воды |
| `04_tester/` | 00 призма + ключи, 01 по одному атому и связи каждого типа (H, N, C, O), 02 гибкость |
| `05_flex_bonds/` | кандидаты гибкой связи: STL, пластины 03 (стоя) и 04 (лёжа, с поддержками), USDZ, `flex_variants.png` |
| `06_v2_test_plates/` | атомы C, O, H и связи к ним на отдельных пластинах |
| `07_v2_new_elements/` | F, Cl, Na, K, Mg, Ca, S, P (+ N): STL, пластины, `README.md` со списком недостающих связей |
| `STATUS.md` | что сделано, что блокирует релиз, что осталось |

Печать: атомы плоскостью вниз, PLA, без поддержек; связи стоя, PETG, brim 5 мм.

## Гибкие связи — кандидаты (05_flex_bonds)
Параметр `FLEX` в SCAD: `"neck"` | `"bellows"` | `"slots"` | `"spring"`. Гибкий участок — 70 % длины стержня, Ø12 снаружи, 45°-пробки на концах (печать стоя любым концом вверх).

| Тип | Устройство | Ожидание |
|---|---|---|
| neck | утонение до Ø7 (текущее) | умеренно гнётся, самый прочный |
| bellows | сильфон: стенка 1,2, шаг 4, шевроны 45° | большой упругий изгиб, длина не меняется, хорошая кручение |
| slots | трубка стенка 1,5 с кольцевыми прорезями 150° в шахматном порядке | гибкость задаётся перемычками; строже выглядит |
| spring | 3 ленты 2×2 по спирали 45° вокруг сердечника Ø4 | изотропный изгиб, «пружинный» вид; сердечник держит длину |

`03_v2_flex_variants_test.3mf` — четыре C–C (neck/bellows/slots/spring) + O–H сильфон и пружина, стоя, 150×16×115 мм, PETG, без поддержек.
`flex_variants.png` — разрезы. Все варианты герметичны, одно тело, 0–1 островок (сильфон/пружина ≤0,3 мм²).
Решение по результату печати → фиксировать `FLEX` в SCAD, перерендерить связи, снять блокер.

### Раскладка для теста гибкости — две пластины
**03 (стоя, без поддержек).** Слои поперёк оси: самая точная геометрия ключей и складок, но изгиб нагружает межслойную связь.
Brim 8 мм (столбики 115 мм), «Slow down for overhangs» вкл.
**04 (лёжа, с поддержками).** Слои вдоль оси — стержень на изгиб в 2–3 раза прочнее, именно так стоит печатать гибкие связи, если
стоячие будут трескаться. Настройки: Enable support ✓, Type tree(auto), On build plate only ✓, Threshold 40°,
Support/raft interface — PLA (если есть AMS) или Top Z distance 0,25 мм; после снятия поддержек пройти ключи шкуркой 600.
Поддержки лягут под сильфон и ленты пружины, под нижние бугорки одинарного ключа и под низ линзы/Рёло.
Сравнивать: одинаковый тип стоя vs лёжа — где трещина при изгибе до 40°, где остаточная деформация.

> Исправление: в первых версиях пластин O–H «сильфон» и «пружина» были гладкими стержнями (порог гибкости 40 мм при длине стержня O–H 38,4 мм). Порог для гибких типов снижен до 24 мм (`flex_min_len`), пластины и STL пересобраны; каждая O–H имеет 1 островок ≤5 мм² (кончик складки/торец пробки).
