api-bar/chem-constructor/docs/SP2_PLANARITY.md

# Плоскостность sp²: исправление двойной связи C=C

Состояние на 2026-10-23.

## Что было
В beta5 этилен H₂C=CH₂ собирался **не плоским**: двугранные углы H–C=C–H были 12° и 168° (вместо 0° и 180°),
шесть атомов отходили от общей плоскости до 8,4 мм. Для углерода sp² все три паза (T0, T1, Д1) лежат в одной плоскости,
поэтому плоскость молекулы целиком определяется поворотом витой щели двойного паза вокруг своей оси (параметр фазы).
Параметр `C_D_PHASE = -55.5` оставлял закрутку 11,5–12°.

## Что сделано
- `00_source/chem_constructor.scad`: `C_D_PHASE = -61.5`. Двугранный угол H–C=C–H = 2·(`C_D_PHASE` + 61,5) по модулю 180°, то есть ровно 0°/180° при −61,5.
- `00_source/seat_cache_v2.json`: пересчитаны посадки двойного паза углерода (угол 96° → 90°, у C=C на обоих концах и у C=O).
- Пересобраны модели, зависящие от углерода: `carbon.stl`, этилен, CO₂, аланин (GLB, USDZ, PNG), пластины с атомами C, тестеры.
- Новый скрипт `00_source/pipeline/check_planar.py`: считает двугранные углы по посадкам и возвращает код 1, если нарушена плоскость у C=C или N=O.

## Результат (по сборке из STL, булева проверка посадки без пересечений)

| Фрагмент | Двугранные углы | Плоскость |
|---|---|---|
| C=C, H₂C=CH₂ было | −168,0° / 12,0° | отклонение до 8,4 мм |
| C=C, H₂C=CH₂ стало | ±180,0° / 0,0° | 0,0 мм |
| N=O, HO–N=O | 0,0° / 180,0° | ✔ (не менялось) |

Углы при sp²-углероде остаются 130° (Д1–T0), 120,5° (Д1–T1) и 109,5° (T0–T1): у этилена H–C–H = 109,5° вместо реальных ≈117°.
Плоскость от этого не страдает.

## Что печатать заново
Только углероды, которые будут стоять в C=C (у них паз Д1 повернут на 6°). Остальные напечатанные углероды (метан, этан, карбонил и т. д.) годятся:
поворот щели Д1 для них ни на что не влияет. Связь C=C не менялась.

## Что осталось неплоским
`check_planar.py` показывает, что при текущих фазах **C=N и N=N не плоские** (отклонение 57° и 66°); раньше каталог это не отмечал.
Расчёт (по аддитивности фаз, на STL не проверен) даёт одну совместимую настройку, при которой плоскими становятся все четыре двойные связи:
`N_D_PHASE` 66 → 123 и фаза двойного паза кислорода 0 → 123 при `C_D_PHASE = -61,5`. Это меняет напечатанные N и O, поэтому не применено.

Аллен H₂C=C=CH₂ (sp): угол между плоскостями концевых CH₂ получается 61° вместо 90°. Исправляется отдельной фазой паза −C_D (сейчас 0).
