api-bar/chem-constructor/02_molecules/Ala_alanine/Ala_alanine.png

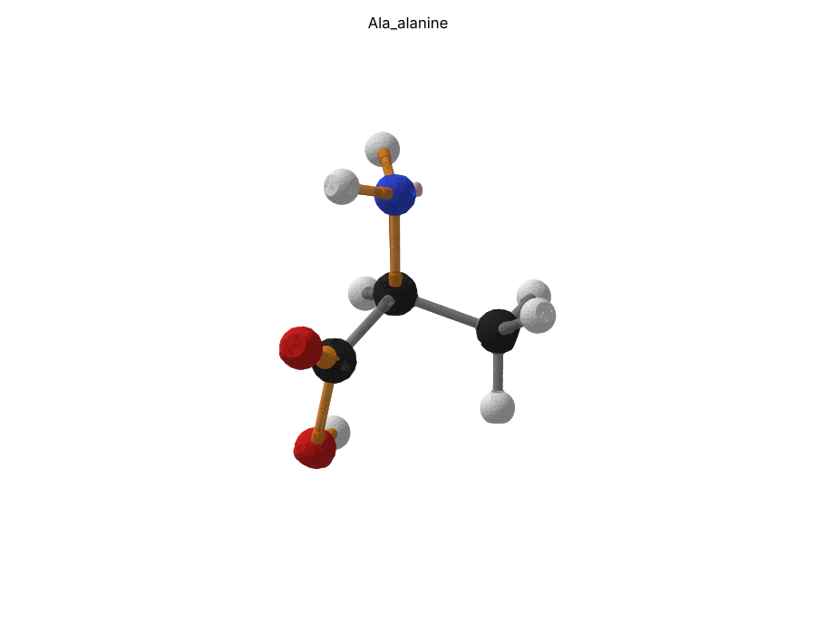
02_molecules/Ala_alanine/Ala_alanine.png
