api-bar/chem-constructor/02_molecules/C2H2_acetylene/C2H2_acetylene.png

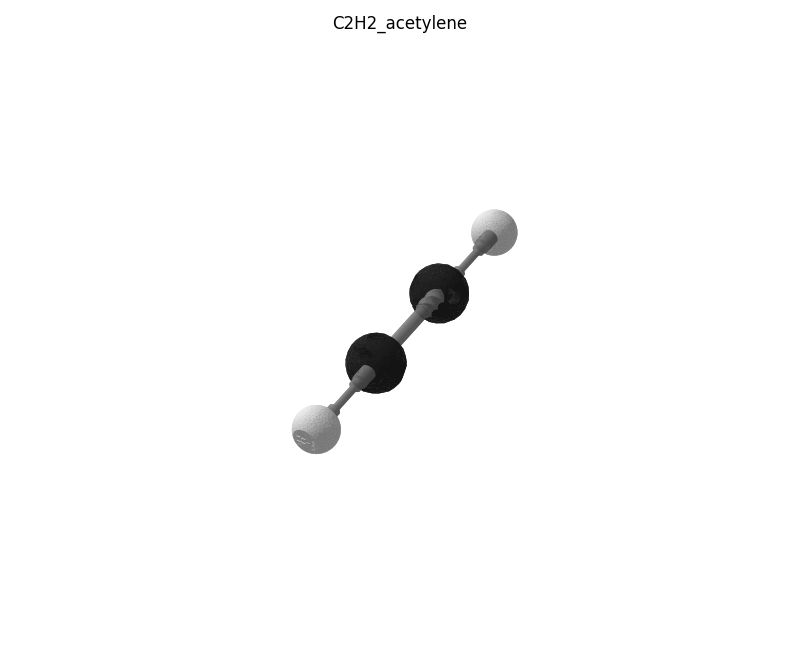
02_molecules/C2H2_acetylene/C2H2_acetylene.png
