api-bar/chem-constructor/02_molecules/C2H4_ethylene/C2H4_ethylene.png

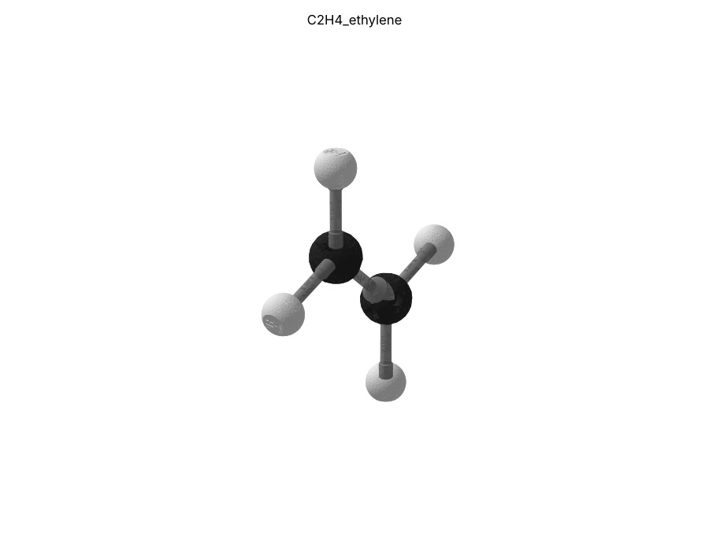
02_molecules/C2H4_ethylene/C2H4_ethylene.png
