api-bar/chem-constructor/02_molecules/C2H5OH_ethanol/C2H5OH_ethanol.png

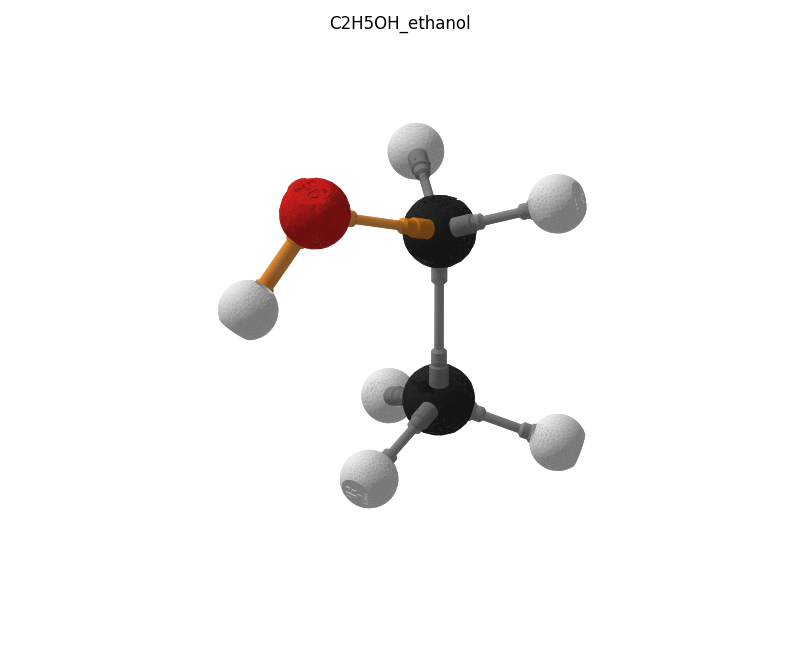
02_molecules/C2H5OH_ethanol/C2H5OH_ethanol.png
