api-bar/chem-constructor/02_molecules/CH4_methane/CH4_methane.png

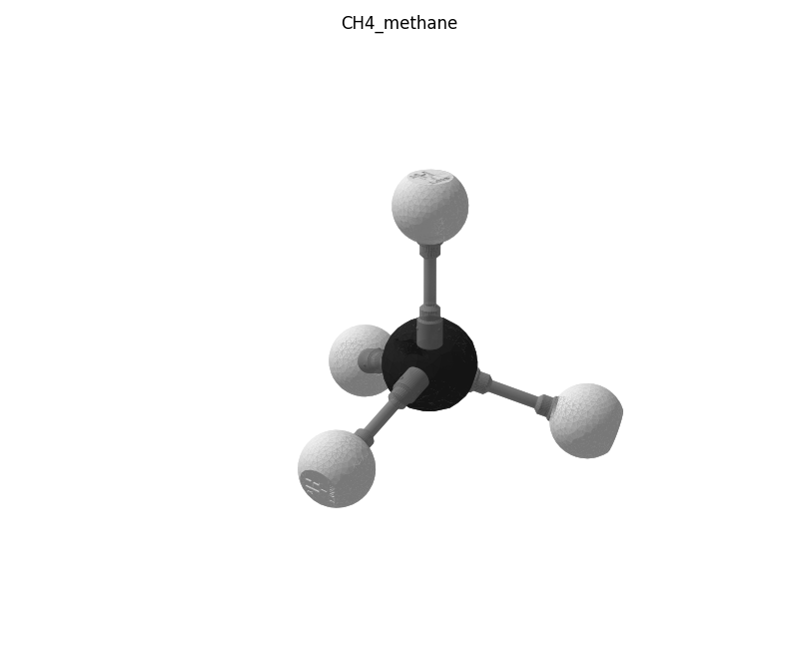
02_molecules/CH4_methane/CH4_methane.png
