api-bar/chem-constructor/02_molecules/CO2/CO2.png

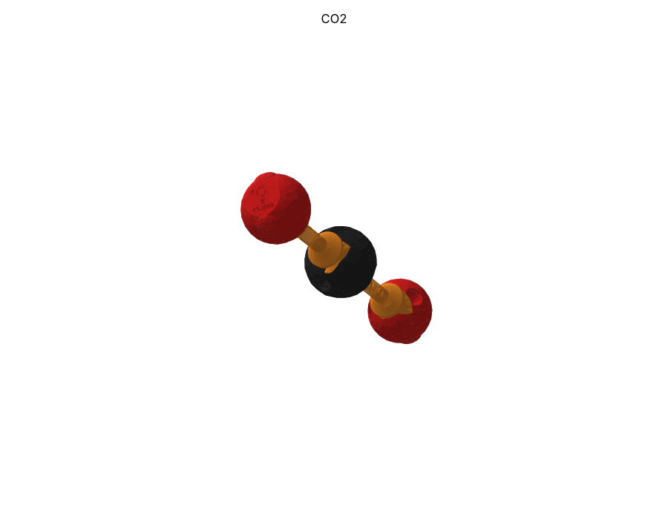
02_molecules/CO2/CO2.png
