api-bar/chem-constructor/02_molecules/cyclohexane/cyclohexane.png

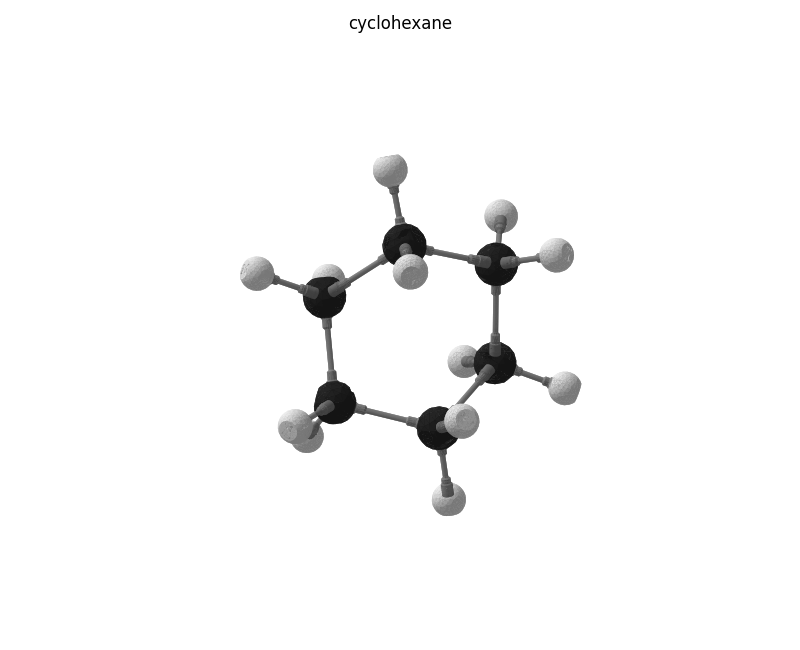
02_molecules/cyclohexane/cyclohexane.png
