api-bar/chem-constructor/02_molecules/H2O_water/H2O_water.png

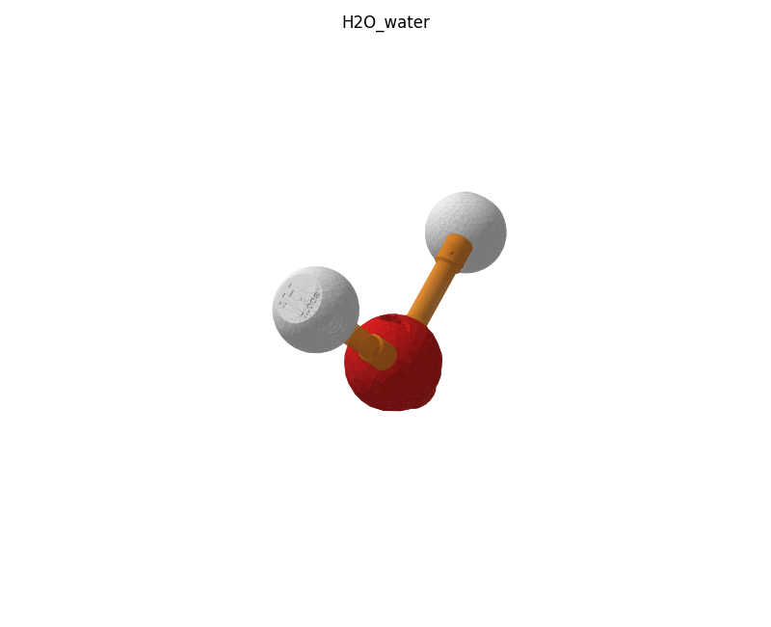
02_molecules/H2O_water/H2O_water.png
