api-bar/chem-constructor/02_molecules/NH3_ammonia/NH3_ammonia.png

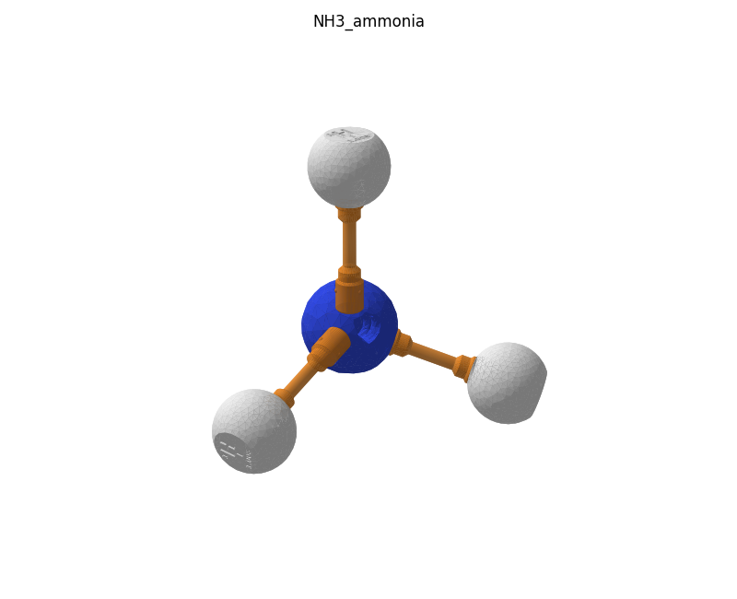
02_molecules/NH3_ammonia/NH3_ammonia.png
