api-bar/chem-constructor/02_molecules/NO/NO.png

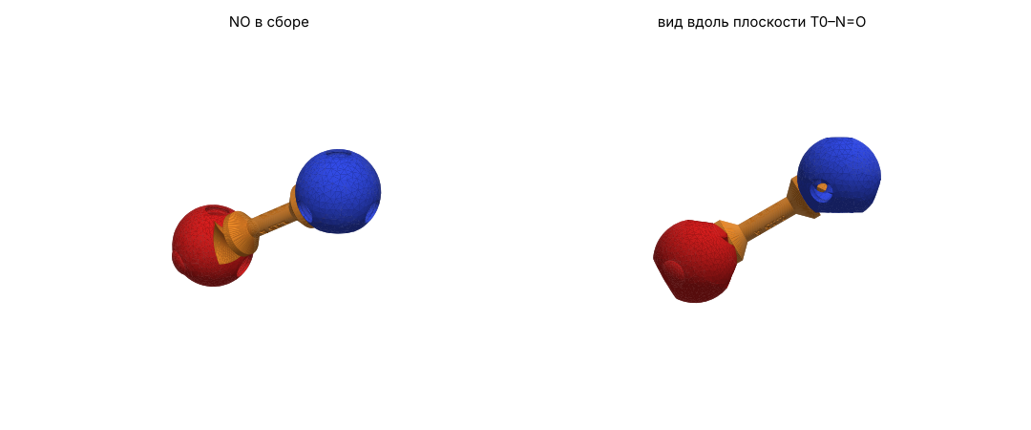
02_molecules/NO/NO.png
