api-bar/chem-constructor/05_flex_bonds/flex2_CC_sections.png

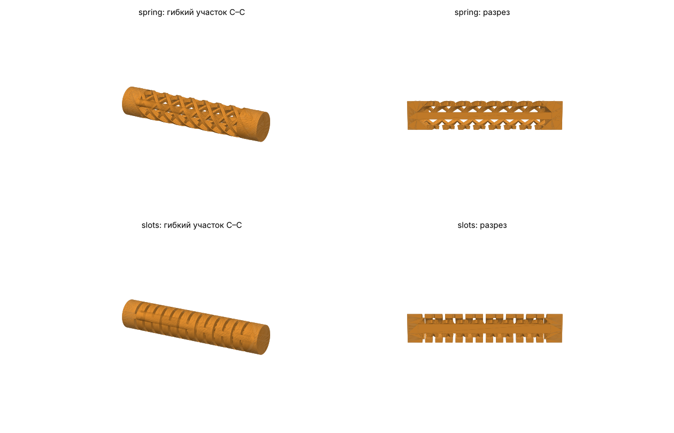
05_flex_bonds/flex2_CC_sections.png
