api-bar/chem-constructor/05_flex_bonds/flex_variants.png

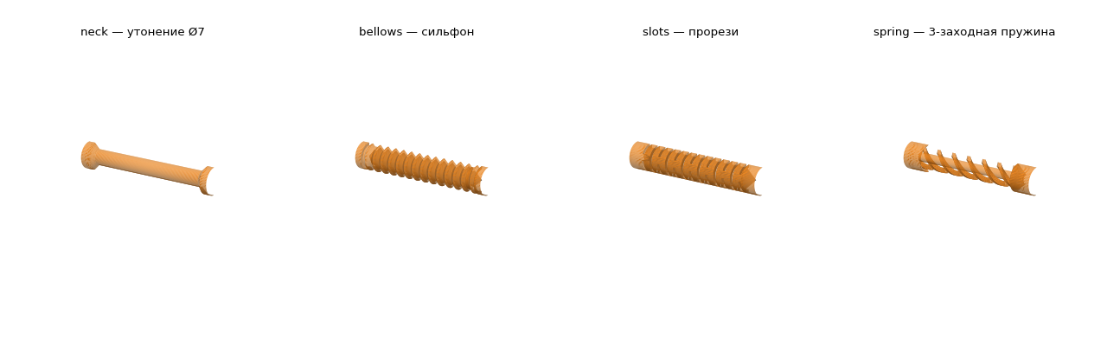
05_flex_bonds/flex_variants.png
