api-bar/chem-constructor/07_v2_new_elements/layout.png

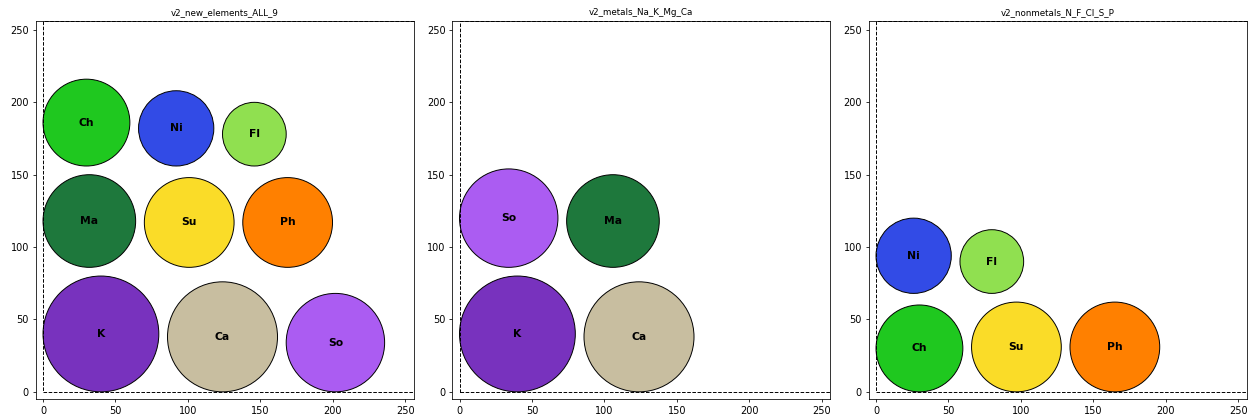
07_v2_new_elements/layout.png
