api-bar/chem-constructor/06_v2_test_plates/README.md

# v2: тест-набор C, O, H

**v2_atoms_C_O_H.3mf** — углерод (8 пазов: 4 одинарных, 2 двойных, 1 тройной), кислород (2 одинарных + двойной), водород (1 одинарный).
Плоскостью с гравировкой вниз. Поддержки выкл.; у углерода 2 мелких островка у устья нижнего паза (10,5 и 2 мм²): включить «Support critical regions only» или игнорировать.

**v2_bonds_for_C_O_H.3mf** — связи, которые закрывают все типы пазов этих трёх атомов: C–H (одинарный паз C и H), O–H (одинарный паз O), C=O (двойной паз C и O), C≡C (тройной паз C). Стоя, без поддержек, brim 5 мм.

## Что проверять по порядку
1. Одинарная: C–H в паз H и в одинарный паз C, O–H в паз O. Совместить бугорки с бороздками, нажать до щелчка; провернуть связь — вращается свободно; вынуть — снова по бороздкам.
2. Двойная: C=O в двойной паз кислорода и в двойной паз углерода; ввинчивать **по часовой**, ~⅓ оборота; щелчок бугорка и зажим клином.
3. Тройная: C≡C в тройной паз углерода (один из трёх положений через 120°).
4. Исключение: линза C=O не входит в одинарный паз и тройной, C≡C — в одинарный и двойной, цилиндр C–H — в двойной и тройной.
5. Сборка: формальдегид H₂C=O (C + O + 2 H, связи C=O и 2×C–H) или вода.
