api-bar/chem-constructor/(commit log)

2026-10-13 Chemistry constructor v1.0
    [chem_constructor.scad]
2026-10-18 Открыть версионную ветку v2 с набором v2.0-beta5
    Ветка v2 — отдельная публикация второй версии набора (бизнес-план: «отдельный репозиторий или ветка с другим LICENSE»); v1.0 остаётся на main.
    Содержимое — выгрузка chem_constructor_v2.0_beta5 с дельтой update2 (C=N, N=N, UD1/UD2/UT, пластина 02 на 22 связи).
    Устаревшие пластина 08 (гибридный NO, заменён связью N=O) и пластина 02 на 19 связей не включены; копия SCAD v1 не нужна — она на m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
    [chem_constructor.scad]
2026-10-18 Добавить сборку и описание ассетов релиза v2.0-beta5
    Бинарники набора (111 файлов, около 400 МБ) в git не хранятся: make_release_assets.sh собирает шесть zip с путями относительно корня ветки,
    docs/RELEASE.md описывает состав каждого ассета и как восстановить полную папку из клона ветки v2.
2026-10-18 Убрать GitHub Release из схемы публикации v2
    Решение автора: STL, 3MF, GLB и USDZ на GitHub не выкладываются, они входят в платный комплект v2. В git остаются скрипты, документация и PNG, на ветку ставится только тег с датой.
    Скрипт архивов переименован в make_kit_archives.sh и складывает архивы комплекта в dist/ для площадки продажи.
2026-10-18 Исправить ссылку на репозиторий в плане публикации v1.0
    Репозиторий перенесён в api-bar/chem-constructor; адрес mrYush/chem-constructor открывается только через редирект GitHub.
2026-10-18 Добавить параметрический исходник SCAD v2 в ветку
    Решение автора: исходник OpenSCAD публикуется вместе со скриптами под лицензией ветки (CC BY-NC-ND 4.0); закрытыми остаются только файлы комплекта (STL, 3MF, GLB, USDZ).
    [chem_constructor.scad]
2026-10-23 Исправить плоскостность этилена: C_D_PHASE -55.5 -> -61.5
    Двугранные углы H-C=C-H были 12°/168° (закрутка, отклонение от плоскости до 8,4 мм),
    стали 0°/180°. Пересчитан seat_cache_v2.json, добавлен pipeline/check_planar.py,
    docs/SP2_PLANARITY.md с результатами и открытыми вопросами (C=N, N=N, аллен),
    обновлены PNG этилена, CO2 и аланина.
    Claude-Session: https://claude.ai/code/session_01UFShqiFHiL7LBFjN7V5Hne
    [chem_constructor.scad]
